chuyedelgado/wro2026_CHUISA-ARCITEP/calib_images/calib_01.jpg

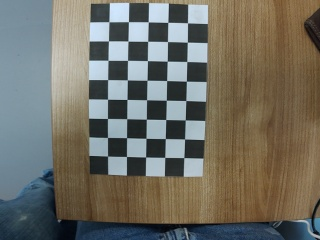
calib_images/calib_01.jpg
