chuyedelgado/wro2026_CHUISA-ARCITEP/calib_images/calib_02.jpg

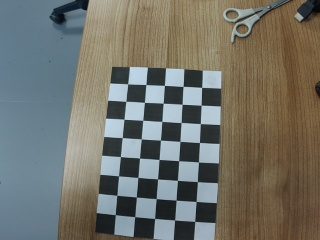
calib_images/calib_02.jpg
