chuyedelgado/wro2026_CHUISA-ARCITEP/calib_images/calib_03.jpg

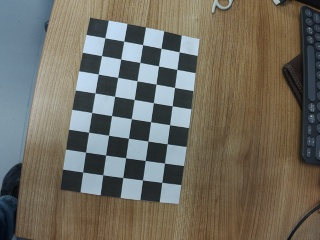
calib_images/calib_03.jpg
