chuyedelgado/wro2026_CHUISA-ARCITEP/calib_images/calib_04.jpg

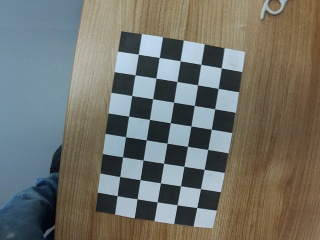
calib_images/calib_04.jpg
