chuyedelgado/wro2026_CHUISA-ARCITEP/calib_images/calib_05.jpg

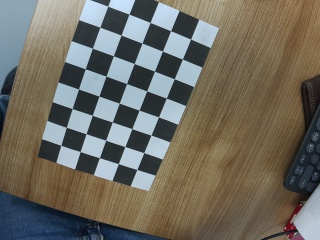
calib_images/calib_05.jpg
