chuyedelgado/wro2026_CHUISA-ARCITEP/calib_images/calib_06.jpg

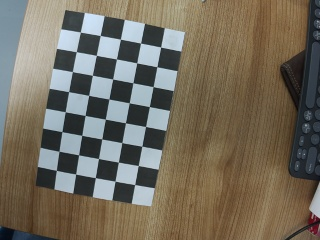
calib_images/calib_06.jpg
