chuyedelgado/wro2026_CHUISA-ARCITEP/calib_images/calib_07.jpg

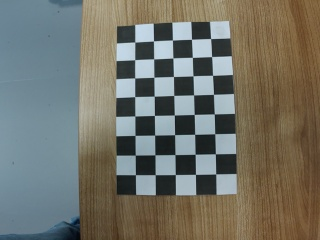
calib_images/calib_07.jpg
