chuyedelgado/wro2026_CHUISA-ARCITEP/calib_images/calib_08.jpg

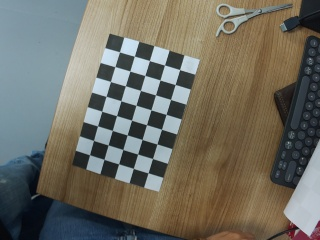
calib_images/calib_08.jpg
