chuyedelgado/wro2026_CHUISA-ARCITEP/calib_images/calib_09.jpg

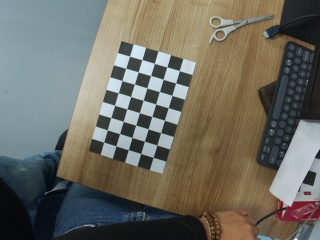
calib_images/calib_09.jpg
