chuyedelgado/wro2026_CHUISA-ARCITEP/calib_images/calib_10.jpg

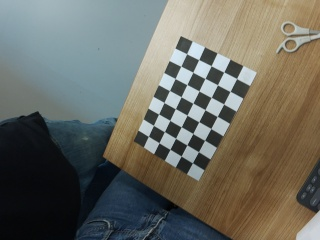
calib_images/calib_10.jpg
