chuyedelgado/wro2026_CHUISA-ARCITEP/calib_images/calib_11.jpg

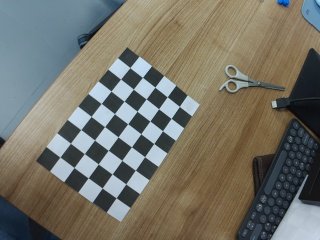
calib_images/calib_11.jpg
