chuyedelgado/wro2026_CHUISA-ARCITEP/calib_images/calib_12.jpg

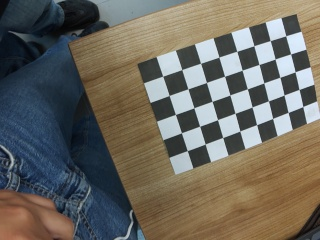
calib_images/calib_12.jpg
