chuyedelgado/wro2026_CHUISA-ARCITEP/calib_images/calib_13.jpg

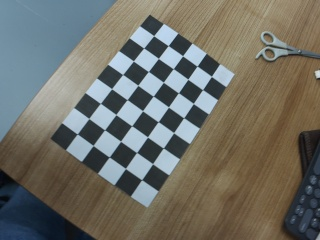
calib_images/calib_13.jpg
