chuyedelgado/wro2026_CHUISA-ARCITEP/calib_images/calib_14.jpg

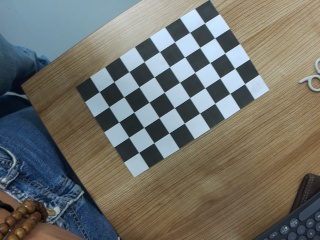
calib_images/calib_14.jpg
