chuyedelgado/wro2026_CHUISA-ARCITEP/calib_images/calib_15.jpg

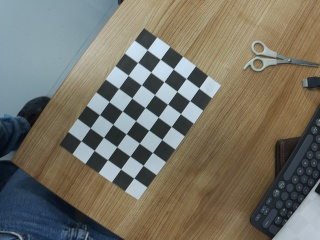
calib_images/calib_15.jpg
