chuyedelgado/wro2026_CHUISA-ARCITEP/calib_images/calib_16.jpg

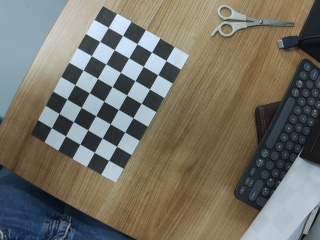
calib_images/calib_16.jpg
