chuyedelgado/wro2026_CHUISA-ARCITEP/calib_images/calib_17.jpg

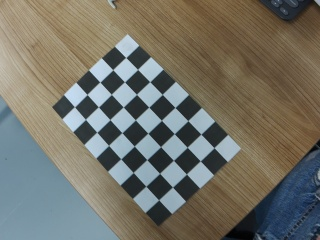
calib_images/calib_17.jpg
