chuyedelgado/wro2026_CHUISA-ARCITEP/calib_images/calib_18.jpg

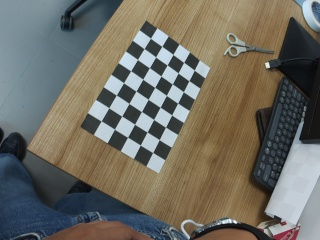
calib_images/calib_18.jpg
