chuyedelgado/wro2026_CHUISA-ARCITEP/calib_images/calib_19.jpg

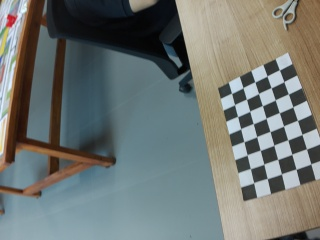
calib_images/calib_19.jpg
