chuyedelgado/wro2026_CHUISA-ARCITEP/calib_images/calib_20.jpg

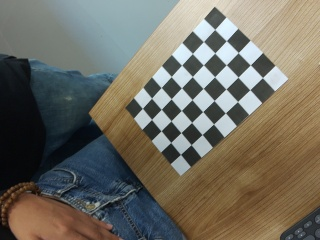
calib_images/calib_20.jpg
