chuyedelgado/wro2026_CHUISA-ARCITEP/comparacion_fisheye.jpg

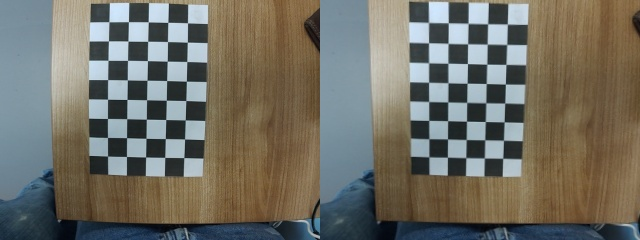
comparacion_fisheye.jpg
