chuyedelgado/wro2026_CHUISA-ARCITEP/other/bill_of_materials.md

# Bill of Materials (BOM) — WRO 2026 Future Engineers
## Equipo CHUISA ARCITEP | Lista de componentes comprados

**Fecha de compra:** 25 de mayo de 2026
**Estado:** Todas las compras ejecutadas y pagadas
**Total invertido:** $1,075.68 USD

---

## RESUMEN POR VENDEDOR

| Vendedor | Items | Total | Estado |
|---|---|---|---|
| Amazon US | 51 | $850.48 | ✅ Pagado, entrega Jun 1-16 |
| Pi Hut UK | 3 (bundle) | $129.40 | ✅ Pagado |
| eBay (WHCD01) | 2 motores | $95.80 | ✅ Pagado |
| **TOTAL** | **56** | **$1,075.68** | ✅ Todo confirmado |

---

## COMPRAS EN AMAZON US ($850.48)

### Sensores y procesamiento

| Componente | Marca/Modelo | Cant | Precio | Función |
|---|---|---|---|---|
| Cámara Pi 152° Ultra Wide | SainSmart Camera Module 3 IMX708 | 1 | $44.99 | Visión principal, FOV máximo |
| MicroSD 32GB Class 10 | SanDisk Ultra UHS-I | 1 | $20.33 | OS Raspberry Pi |
| Sensores ToF (4-pack) | ACEIRMC TOF400C VL53L1X | 1 | $21.89 | Distancia paredes laterales |
| IMU MPU-6050 (3-pack) | HiLetgo GY-521 | 1 | $11.79 | Giroscopio yaw + repuestos |
| Pi 5 Active Cooler oficial | Raspberry Pi Foundation | 1 | $9.99 | Refrigeración crítica |
| Pasta térmica MX-4 | ARCTIC | 1 | $5.49 | Para active cooler |

### Microcontrolador y drivers

| Componente | Marca/Modelo | Cant | Precio | Función |
|---|---|---|---|---|
| Arduino Nano Every (3-pack) | Arduino oficial | 1 | $38.00 | MCU bajo nivel + repuestos |
| Motor driver | Cytron MD10C 13A | 3 | $45.90 | Driver para JGB37-520 |
| UBEC 5V/6V 8A | FEICHAO Switch Mode | 2 | $37.96 | BEC servo (6V) |
| Mini560 Buck 5V/5A (10-pack) | DORHEA | 1 | $12.99 | BEC dedicado Pi (5V) |

### Power y baterías

| Componente | Marca/Modelo | Cant | Precio | Función |
|---|---|---|---|---|
| LiPo 3S 1500mAh 100C (2-pack) | GOLDBAT | 1 | $23.99 | Baterías principales |
| Cargador LiPo balanceado | Havcybin IMAX B6 80W | 1 | $34.98 | Carga balanceada |
| LiPo safety bag (2-pack) | PAWBOSE | 1 | $9.99 | Seguridad almacenamiento |
| XT60 connectors (5 pares) | Generic 14AWG | 1 | $10.99 | Conectores batería |

### Mecánica — Chasis Prototipo 1

| Componente | Marca/Modelo | Cant | Precio | Función |
|---|---|---|---|---|
| WLtoys A959-B 1/18 RC car RTR | WLtoys (Gulitech) | 1 | $123.91 | Chasis Prototipo 1 completo |

### Mecánica — Ruedas y dirección

| Componente | Marca/Modelo | Cant | Precio | Función |
|---|---|---|---|---|
| Ruedas 65mm hex 12mm | ShareGoo OD 2.55" Rubber | 1 | $12.99 | Ruedas Prototipo 2 |
| Hex hubs 5→12mm (4pcs) | MOHERO | 1 | $10.99 | Adaptador eje-rueda |
| Servo metal gear 20kg | Power HD ALIENTAC LF-20MG | 2 | $49.98 | Dirección + repuesto |
| Servo horns 25T aluminio | YijiaLink | 1 | $8.99 | Brazos del servo |

### Mecánica — Ejes y chasis

| Componente | Marca/Modelo | Cant | Precio | Función |
|---|---|---|---|---|
| Stainless rods 5×300mm (6pcs) | MECCANIXITY 304 | 1 | $12.39 | Ejes de tracción y dirección |
| Rodamientos MR105ZZ (10pcs) | KABOBEARING | 1 | $7.49 | Soporte de ejes |
| Bushings SF-1 bronce 3×5×6mm (10pcs) | PRECISCRY | 1 | $10.27 | Pivotes kingpin |
| Shaft Lock Collars 5mm (10pcs) | uxcell | 1 | $9.79 | Fijación axial |
| Plum Coupling 5→6mm | AOWEITAL D25×L30 | 2 | $23.98 | Acople motor-eje |
| Threaded Rod M3×150mm (10pcs) | Mriuuod 304 SS | 1 | $7.69 | Tie rods de dirección |
| Ball Joints M3 (10pcs) | ShareGoo Aluminum | 1 | $11.89 | Articulaciones tie rods |

### Encendido y protección

| Componente | Marca/Modelo | Cant | Precio | Función |
|---|---|---|---|---|
| DPST Switch 12V 16A iluminado (2-pack) | Twidec KCD2-201N | 1 | $8.99 | Switch encendido (Regla 9.10) |
| Arcade button 24mm LED 5V (5-pack) | EG STARTS | 1 | $11.99 | Botón inicio (Regla 9.11) |
| Glass Fuse Kit + Holder | BOJACK 5×20mm | 1 | $11.99 | Protección motor |
| PolySwitch RXEF300 3A (10-pack) | Generic PPTC | 1 | $7.53 | Protección lógica auto-reset |

### Electrónica — Conexiones

| Componente | Marca/Modelo | Cant | Precio | Función |
|---|---|---|---|---|
| JST-XH Connector Kit (630pcs) | EGSCST XH2.54mm | 1 | $9.99 | Conectores señales |
| Pin Headers 2.54mm (20pcs M+F) | OCR | 1 | $7.49 | Headers PCBs |
| Screw Terminals (70pcs) | Tnisesm TN-T03B | 1 | $8.99 | Bornes placas |
| PCB perforada 7×9cm (8pcs) | Enksagd Double-Sided | 1 | $9.99 | Prototipo PCBs |
| Dupont Wires (120pcs) | ELEGOO M-F/M-M/F-F | 1 | $6.98 | Cables jumper |
| Nylon Standoffs M3 (580pcs) | Generic | 1 | $8.59 | Separadores PCB |

### Capacitores

| Componente | Marca/Modelo | Cant | Precio | Función |
|---|---|---|---|---|
| Capacitores cerámicos 0.1μF (50pcs) | BOJACK | 1 | $6.99 | Desacoplo HF |
| Capacitores electrolíticos 100μF/16V (15pcs) | Rubycon | 1 | $5.99 | Desacoplo medio |
| Capacitores electrolíticos 470μF/16V (15pcs) | Rubycon | 1 | $5.99 | Desacoplo bulk |

### Cableado y consumibles

| Componente | Marca/Modelo | Cant | Precio | Función |
|---|---|---|---|---|
| Cable silicona 16AWG (10ft+10ft) | Generic | 1 | $7.99 | Cableado power |
| Heat Shrink Kit (580pcs, 11 sizes) | Ginsco 2:1 | 1 | $7.99 | Termo-encogibles |
| Kapton Tape 4-pack | ELEGOO High Temp | 1 | $9.99 | Cinta alta temp |
| 3M Super-Strength Tape | 3M 03614 | 1 | $13.64 | Doble cara general |
| 3M Dual Lock SJ3550 | 3M | 1 | $14.95 | Velcro fuerte para baterías |
| Zip Ties 4" (200-pack) | Tantti Supply | 1 | $3.99 | Sujeción cables |
| EVA Foam 3mm Sheet | MEARCOOH Black | 1 | $9.96 | Aislamiento IMU vibración |

### Adhesivos y limpieza

| Componente | Marca/Modelo | Cant | Precio | Función |
|---|---|---|---|---|
| Super Glue Liquid (12×3g) | WOUSEDO Cyanoacrylate | 1 | $5.92 | Pegado ruedas a rines |
| Isopropyl Alcohol 99.9% (8oz) | MaxTite | 1 | $7.95 | Limpieza pre-pegado |
| Loctite 243 Blue Threadlocker | Henkel | 1 | $14.97 | Fijación tornillos críticos |

### Cable de video

| Componente | Marca/Modelo | Cant | Precio | Función |
|---|---|---|---|---|
| Cable Micro-HDMI 35cm backup | SMALLRIG 3042B | 1 | $7.99 | Backup HDMI |

### Tornillería

| Componente | Marca/Modelo | Cant | Precio | Función |
|---|---|---|---|---|
| Kit Tornillos M2/M3/M4/M5 (1760pcs) | Fgruh Grade 12.9 | 1 | $21.99 | Tornillería completa |

**Subtotal Amazon: $850.48**

---

## COMPRAS EN PI HUT UK ($129.40)

Bundle de 3 productos en un solo pedido:

| Componente | Marca/Modelo | Cant | Precio | Función |
|---|---|---|---|---|
| Raspberry Pi 5 (4GB) | Raspberry Pi Foundation | 1 | (bundle) | Cerebro principal |
| Cable Micro-HDMI a HDMI 3ft | Pi Hut | 1 | (bundle) | Video desarrollo |
| Pi 5 27W USB-C Power Supply | Raspberry Pi oficial | 1 | (bundle) | Fuente alimentación |
| **TOTAL Bundle** | | | **$129.40** | |

---

## COMPRAS EN EBAY ($95.80)

| Componente | Vendedor | Cant | Precio | Función |
|---|---|---|---|---|
| Motor JGB37-520 12V 530RPM con encoder Hall + Bracket | WHCD01 (100% positive) | 2 | $95.80 | Motor de tracción + repuesto |

Vendedor: **WHCD01** — 100% positive feedback
Configuración seleccionada:
- DC 12V
- 530 RPM
- Motor + Bracket

---

## VERIFICACIÓN DE CUMPLIMIENTO DE REGLAS WRO

| Componente que aplica | Regla WRO | Cumplimiento |
|---|---|---|
| Twidec DPST Switch | Regla 9.10 (un interruptor) | ✅ Corta ambas baterías |
| EG STARTS Arcade Button 5V | Regla 9.11 (un botón inicio) | ✅ Push button único |
| Cytron + Arduino + Pi | Sin propietarios | ✅ Todos COTS estándar |
| Diseño objetivo 280×200×180mm | Regla 9.8 | ✅ Dentro de 300×200×300mm |

---

## NOTAS SOBRE PRESUPUESTO

**Presupuesto original:** $800 USD
**Presupuesto final ejecutado:** $1,075.68 USD
**Sobrecosto:** $275.68 (~35%)

**Justificación del sobrecosto:**
- Estrategia de dos prototipos requiere electrónica duplicada
- Repuestos críticos comprados para componentes susceptibles a daño (motor con encoder, servo, drivers)
- Compra del WLtoys en Amazon US en lugar de eBay China — pagamos premium por delivery garantizado
- Componentes de calidad superior donde el costo extra protege inversión mayor (Mini560 fijo vs ajustable barato para proteger Pi 5)

---

## CRONOGRAMA DE LLEGADA DE COMPONENTES

| Vendedor | Fecha estimada |
|---|---|
| Amazon US (mayoría) | Junio 1, 2026 |
| Amazon US (algunos vendedores externos) | Junio 5-16, 2026 |
| Pi Hut UK | Junio 5-10, 2026 (estimado) |
| eBay (China via SpeedPAK) | Junio 10-25, 2026 |

**Estrategia:** Empezar trabajo de visión y software en cuanto llegue la Pi 5 + componentes electrónicos básicos (~Jun 5). Mecánica se ensambla cuando lleguen ejes, rodamientos y motor (~Jun 15-20).

---

*Documento mantenido por: Equipo CHUISA ARCITEP*
*Última actualización: 25 de mayo de 2026*
