chuyedelgado/wro2026_CHUISA-ARCITEP/comparacion_calibracion.jpg

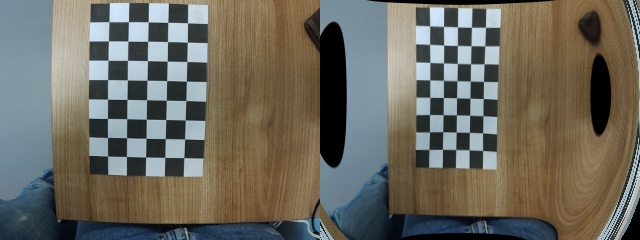
comparacion_calibracion.jpg
