chuyedelgado/wro2026_CHUISA-ARCITEP/docs/journal/journal_2026-06-15.md

# REGISTRO DE EJECUCIÓN — JOURNAL TÉCNICO
## WRO 2026 Future Engineers | Equipo CHUISA ARCITEP
*Ubicación sugerida: `docs/journal/2026-06-15.md`*

---

## 2026-06-15 — Semana 1 · Bloque 3 (Sensores I2C) ✅ COMPLETADO

### Arduino Nano Every — prueba de vida
- Cadena de herramientas verificada (Arduino IDE + paquete "Arduino megaAVR Boards") con el sketch Blink; el LED responde a cambios de `delay` → confirma que se compila y sube código propio.
- **Aprendizaje (punto de falla resuelto):** el mensaje `avrdude: jtagmkII_initialize(): Cannot locate "flash" and "boot" memories in description` es una **advertencia inofensiva** del Nano Every — aparece en CADA subida exitosa, no es un error. Una subida realmente fallida mostraría mensajes adicionales (p. ej. `jtagmkII_getsync(): sign-on command: status -1`). Confirmado contra la documentación oficial de Arduino.

### Montaje — primera soldadura
- Soldados los headers de: **MPU-6050 (GY-521)**, **Arduino Nano Every** y **2× VL53L1X (TOF400C)**.
- Técnica: header clavado en la protoboard como soporte para mantener los pines a 90°; soldar primero dos esquinas opuestas para fijar, luego el resto.

### Sensores I2C (bring-up incremental)

**MPU-6050 (IMU) — dirección 0x68**
- Detectado con escáner I2C. Lectura de yaw con la librería **MPU6050_light** (rfetick).
- Calibración de bias (`calcOffsets`) con el sensor en reposo al arrancar.
- Yaw sigue los giros (verificado girando el sensor ~90° y 360°).
- Drift del giroscopio: **~0.5° en 1 minuto** (medido dejando el sensor en reposo y leyendo el yaw durante 60 s). Muy bajo y manejable: despreciable frente a giros de 90° y a vueltas que duran segundos, no minutos.

**VL53L1X (ToF) — dirección de fábrica 0x29**
- Detectado con escáner. Lectura de distancia en mm con la librería **VL53L1X** (Pololu); modo Long, timing budget 50 ms, medición continua.
- **Distancia mínima medible observada ≈ 20 mm. Es una característica del sensor, NO una falla.** Irrelevante para la aplicación: el setpoint de wall-following es ~250–300 mm y los corredores miden 600–1000 mm.
- Precisión contra distancia conocida: **±3 mm** (medido contra un objeto a 100 mm). CUMPLE el criterio de validación de ±5 mm con margen.

**Multi-sensor en un solo bus (re-direccionamiento XSHUT)**
- **Problema:** los dos ToF salen de fábrica en la MISMA dirección 0x29 → conflicto en el bus I2C.
- **Solución XSHUT:** apagar ambos ToF, encender el #1 y reasignarlo a 0x2A, luego encender el #2 (queda en 0x29).
- Cableado: XSHUT del #1 → D2, XSHUT del #2 → D3.
- Truco de control: `pinMode(XSHUT, INPUT)` = encendido (pull-up interno del módulo); `OUTPUT` en LOW = apagado.
- Verificado: tapar un ToF cambia solo su lectura, el otro se mantiene.

**Tres dispositivos en un bus — HITO S1 "I2C con 3+ dispositivos" ✅**
- El escáner detecta: 0x29 (ToF), 0x2A (ToF), 0x68 (MPU). Total: 3.
- Lectura conjunta: dos distancias + yaw a la vez, cada uno responde de forma independiente.
- Nota de arquitectura: los 3 sensores comparten solo 2 líneas de datos (SDA/SCL) — la razón por la que se eligió I2C.

### Código
- `other/tests/sensores_i2c_test/sensores_i2c_test.ino`: lee los 3 sensores juntos (semilla del futuro `main.ino`).
- Nota: la asignación izquierda/derecha de los ToF es provisional hasta el montaje físico en el chasis.

### Mediciones pendientes (cero datos inventados — marcar pendientes)
- [x] Drift del giroscopio: ~0.5° en 1 min ✅
- [x] Precisión del ToF: ±3 mm @ 100 mm (criterio ±5 mm) ✅
- [ ] (Opcional, refuerzo) Verificar precisión ToF también a ~250 mm y ~500 mm (rango real de uso).

### Próximo
- Bloque 4: protocolo UART Pi ↔ Arduino. ⚠️ Atención a los niveles de voltaje: Nano = 5 V, Pi = 3.3 V.
