chuyedelgado/wro2026_CHUISA-ARCITEP/(commit log)

2026-05-24 feat: initial commit — repo structure, code skeleton, README, engineering journal
2026-05-26 docs: comprehensive update post-component purchases
    - Updated engineering journal with 24 documented design iterations
    - Added bill of materials with all 56 purchased components (,075.68)
    - Refreshed README with current project status and architecture diagrams
    - Document all 24 reverted decisions during component selection process
    - Reflect final component selections (SainSmart 152° cam, JGB37-520 530RPM, ShareGoo 65mm wheels, etc.)
    - Add detailed power architecture and rule compliance verification
2026-06-11 feat: script de prueba de captura con picamera2
2026-06-11 feat: calibracion fisheye lente 152 (error 0.61px vs 2.39 estandar)
    [calibrate_camera.py, calibrate_fisheye.py, capture_calibration.py]
2026-06-12 feat: calibrador HSV y rangos de color verde/rojo en config.py
2026-06-12 docs: journal, decision de vision HSV y plan de calibracion en competencia
2026-06-15 feat: lectura de 3 sensores I2C (2 ToF + IMU) y journal bloque 3
2026-06-15 feat: protocolo UART con checksum y failsafe + journal bloque 4
    [uart_comm_test.py, uart_protocolo_test.ino]
2026-06-15 feat: telemetria Arduino->Pi (2 ToF + yaw) con checksum; bloque 4 cerrado
2026-06-16 chore: estructura de carpetas WRO-FE + limpieza de .DS_Store
2026-06-17 docs: diagrama de cableado (potencia + señal) en schemes/
2026-06-17 docs: diagrama FSM en schemes/ e incrustar wiring + FSM en el README
2026-06-23 docs: journal 2026-06-23 - cierre Bloque 5 (bring-up servo)
2026-06-24 docs: journal 2026-06-23 - riel Pi (Mini560 5V validado bajo carga)
2026-06-25 docs: journal 2026-06-24 - riel motor (Cytron + JGB37, corrientes medidas)
2026-06-28 docs: journal 2026-06-28 - switch DPST + PolySwitch (arbol de potencia cerrado)
2026-06-29 docs: journal 2026-06-28 - placa de sensores I2C (perfboard validada, 3 dispositivos)
2026-06-29 docs: journal 2026-06-29 - UART migrado a placa permanente (enlace validado)
2026-07-01 feat: firmware real Arduino - sensores, actuadores, encoder, UART checksum+failsafe, FSM boton/LED
    [main.ino]
2026-07-01 docs: journal 2026-06-30 - firmware Arduino completo (modulos, protocolo, decisiones)
